RobMeades/DMUClass116/corridor_joiner.jpg

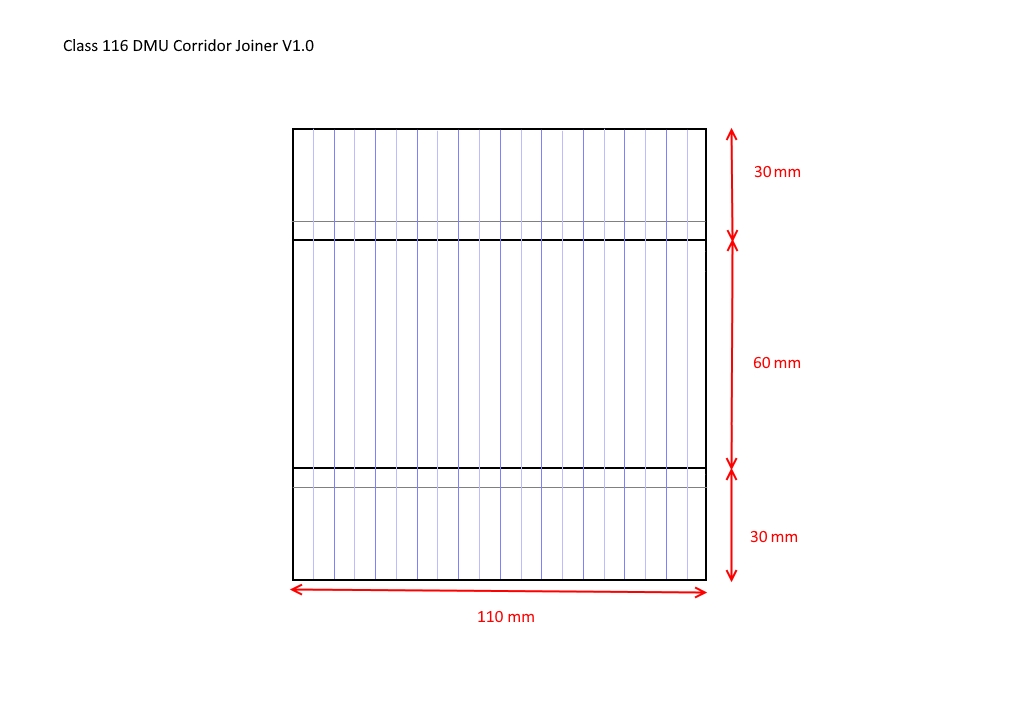
corridor_joiner.jpg
