RobMeades/DMUClass116/(list of files, cad)

Other CAD files:
body_internal_supports.blend
body_motor_open_second_and_brake_section_2.blend
body_motor_open_second_and_brake_section_3.blend
body_motor_open_second_brake_section_1.blend
body_motor_open_second_brake_section_4.blend
body_motor_open_second_brake_section_5.blend
body_motor_open_second_section_1.blend
body_motor_open_second_section_4.blend
body_motor_open_second_section_5.blend
body_roof_former.blend
buffer_bar.blend
cab_front_and_roof.blend
chassis.blend
corridor_joiner.blend
dmu_library.blend
drivers_steps.blend
partitions.blend
seats.blend
