RobMeades/DMUClass116/(commit log)

2019-01-08 Initial commit.
    [body.blend, cab_front_and_roof.blend, chassis.blend]
2019-01-09 Add note about resolution of chassis side printing.
2019-01-10 Add slots for battery holder.
2019-01-12 New version of cab front and roof with no requirements for added supports from a slicer and places for mounting LEDs in the head lamp holes.
    [cab_front_and_roof.blend]
2019-01-19 Correct 2.5 mm vertical offset in the VCarve files, minor mod to README.md.
2019-01-19 Move battery holder slots slightly.
2019-01-19 Re-correct the correction to the hole spacing (it's 1/32 scale, not 1/30.48 scale!).
2019-01-20 More advice on milling.
2019-01-22 Add driver's steps file.
    [drivers_steps.blend]
2019-01-27 Update chassis, add first proper body part and add library of components/tools.
    [body_motor_open_second_section_5.blend, chassis.blend, dmu_library.blend]
2019-01-27 Add lip to help with joining segments.
    [body_motor_open_second_section_5.blend]
2019-01-27 Add seats.
    [seat.blend]
2019-01-27 seat.blend -> seats.blend.
    [seat.blend]
2019-01-27 Really seat.blend -> seats.blend this time.
    [seats.blend]
2019-01-27 Add unpaired seats.
    [seats.blend]
2019-01-28 Add motor open second body section 4, update body section 5 and library, editorial changes to README.md.
    [body_motor_open_second_section_4.blend, body_motor_open_second_section_5.blend, dmu_library.blend]
2019-01-28 Updates mostly to the position of supports after test prints and also added a ridge, mid-body, for the separator in section 4. Editorial changes in README.md.
    [body_motor_open_second_section_4.blend, body_motor_open_second_section_5.blend]
2019-01-28 Move forward part of lower rim forward by 3 cm after test fitting.
    [body_motor_open_second_section_5.blend]
2019-01-28 Update seats after test print.
    [seats.blend]
2019-01-29 Update to seats after final test print.
    [seats.blend]
2019-01-29 Final length adjustments after test fitting.
    [body_motor_open_second_section_4.blend, body_motor_open_second_section_5.blend]
2019-01-30 Section 3 of the motor open second body added.
    [body_motor_open_second_section_3.blend]
2019-01-31 Minor edits after test print of motor body section 3.
    [body_motor_open_second_section_3.blend]
2019-02-01 Add section one of the motor open second body.
    [body_motor_open_second_section_1.blend]
2019-02-01 Add inner ridge to motor open body section 3 and removed drivers window punch from library (since, by inspection of the pictures, the driver's window is, in fact, the same height as the passenger win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
    [body_motor_open_second_section_3.blend, dmu_library.blend]
2019-02-02 Added final section (section 2) of motor open second body. Update section 1 of motor open second body after final test print. Modified seats to be narrower at the top. Minor updates to README.md.
    [body_motor_open_second_section_1.blend, body_motor_open_second_section_2.blend, seats.blend]
2019-02-02 Corrected height of windows in doors
    [body_motor_open_second_section_1.blend, body_motor_open_second_section_2.blend, body_motor_open_second_section_3.blend, body_motor_open_second_section_4.blend, body_motor_open_second_section_5.blend, dmu_library.blend]
2019-02-03 Add first revision of motor open second brake body section 5.
    [body_motor_open_second_brake_section_5.blend]
2019-02-03 Update to motor open body section 1 after final fitting of all the sections on the chassis. Add the gaps for the door steps to motor open second brake section 5.
    [body_motor_open_second_brake_section_5.blend, body_motor_open_second_section_1.blend]
2019-02-03 Minor fix in motor open second body section 1, general updates to README.md.
    [body_motor_open_second_section_1.blend]
2019-02-03 Add window supports to motor open brake section 5. Modify all window supports to print reliably in ASA.
    [body_motor_open_second_brake_section_5.blend, body_motor_open_second_section_1.blend, body_motor_open_second_section_2.blend, body_motor_open_second_section_3.blend, body_motor_open_second_section_4.blend, body_motor_open_second_section_5.blend, dmu_library.blend]
2019-02-04 Add a lip around the lower edge of all of the body sections to aid alignment and close up a potential gap. Add square nut holders to sections 1, 2 and 4. Minor updates to README.md.
    [body_motor_open_second_section_1.blend, body_motor_open_second_section_2.blend, body_motor_open_second_section_3.blend, body_motor_open_second_section_4.blend, body_motor_open_second_section_5.blend]
2019-02-05 Correct position of nut holder after test print.
    [body_motor_open_second_section_1.blend]
2019-02-05 Added holes to screw fixings and corrected support offset.
    [body_motor_open_second_section_4.blend]
2019-02-06 Reduce the window slot thickness to give the outer parts of the sides more strength. Finish motor open second brake section 5 and fix support positions in motor open second section 4.
    [body_motor_open_second_brake_section_5.blend, body_motor_open_second_section_1.blend, body_motor_open_second_section_2.blend, body_motor_open_second_section_3.blend, body_motor_open_second_section_4.blend, body_motor_open_second_section_5.blend]
2019-02-07 Add partitions.blend.
    [partitions.blend]
2019-02-07 Corrected slope of side on wide double seat.
    [seats.blend]
2019-02-07 Oops, restore accidentally deleted seats.blend.
    [seats.blend]
2019-02-07 Complete all of the partitions.
    [partitions.blend]
2019-02-08 Another minor seat slant adjustment and a final attempt to get the length of the motor open second body section 3 correct: 80 mm brute force this time to give me 2.5 mm in the print.
    [body_motor_open_second_section_3.blend, seats.blend]
2019-02-09 Put accidentally deleted seats.blend back again. Move 80 mm length extension on section 3 of the motor open second body into section 4 instead to avoid a slightly odd length door.
    [body_motor_open_second_section_3.blend, body_motor_open_second_section_4.blend, seats.blend]
2019-02-09 Add 2 mm margin to the rear of motor open second section 2 and add clarification concerning ASA printing in README.md.
    [body_motor_open_second_section_2.blend]
2019-02-10 Fix strange skew in motor open second section 2 (it was 3 cm shorter on the left than on the right). Remove lip from rear-most flange of motor open second section 1 as it was too difficult to put int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
    [body_motor_open_second_section_1.blend, body_motor_open_second_section_2.blend]
2019-02-10 Actually fix flange length of forward flange on motor open second section 1 this time; previous commit had fix for length of forward flange on motor open second section _2_.
    [body_motor_open_second_section_1.blend]
2019-02-10 Last commit was of an older file, make fix in the right file now and also shift the left-most nut trap to match its mate on section 2.
    [body_motor_open_second_section_1.blend]
2019-02-10 Removed spurious jigsaw object.
    [drivers_steps.blend]
2019-02-10 Hopefully really fix the darned wide seat pair slope this time.
    [seats.blend]
2019-02-11 Turn all the doors on the right hand sides of all motor open second body sections around so that they open the correct way; handles are always on the right as you face the door from the outside.
    [body_motor_open_second_section_1.blend, body_motor_open_second_section_2.blend, body_motor_open_second_section_3.blend, body_motor_open_second_section_4.blend, body_motor_open_second_section_5.blend]
2019-02-12 First draft of corridor_joiner.blend.
    [corridor_joiner.blend]
2019-02-12 Add final door stop on right hand driver's side door.
    [body_motor_open_second_section_1.blend, cab_front_and_roof.blend]
2019-02-12 Added lip on corridor joiner and made hole in end of motor open second body to take it.
    [body_motor_open_second_section_5.blend, corridor_joiner.blend]
2019-02-12 Corrected corridor joiner height.
    [body_motor_open_second_section_5.blend, corridor_joiner.blend, dmu_library.blend]
2019-02-13 Changed the form of the lip on the corridor joiner: it should now push inside the door-hole in motor open second body section 5.
    [corridor_joiner.blend]
2019-02-14 Adjust corridor joiner width/height once more, add some notes about printing flexible material to README.md.
    [corridor_joiner.blend]
2019-02-14 Remove the corridor joiner segment library part from dmu_library.blend as I've since modified the form quite a lot in corridor_joiner.blend.
    [dmu_library.blend]
2019-02-14 Switch the sub-surface modified back on on Motor Open Second Body section 2.
    [body_motor_open_second_section_2.blend]
2019-02-14 Triangulate one face I missed on Motor Open Second Body section 4.
    [body_motor_open_second_section_4.blend]
2019-02-15 Triangulate a few more faces on Motor Open Second Body section 1.
    [body_motor_open_second_section_1.blend]
2019-02-15 Fixed a few little funnies.
    [body_motor_open_second_section_4.blend]
2019-02-16 Reduce width of 2-seater seat slightly to accommodate the extra wall-thickness of the model.
    [seats.blend]
2019-02-16 Corrected driver's partition; moved the door to be central.
    [partitions.blend]
2019-02-16 Corrected corridor opening position in motor open second section 5, added same to motor open second brake section 5 and final update to drivers door partition.
    [body_motor_open_second_brake_section_5.blend, body_motor_open_second_section_5.blend, partitions.blend]
2019-02-17 First version of motor open second brake section 4, tidy up of motor open second brake section 5 and next version of corridor joiner plan.
    [body_motor_open_second_brake_section_4.blend, body_motor_open_second_brake_section_5.blend, corridor_joiner.blend]
2019-02-17 Add subsurface modifier and slightly increase size of rib after size test.
    [corridor_joiner.blend]
2019-02-17 Make the corridor joiner mould sacrificial.
    [corridor_joiner.blend]
2019-02-17 Position parts so that they are correct for printing without need for rotation in a slicer programme.
    [corridor_joiner.blend]
2019-02-17 Additional advice on how to print corrider_joiner.blend.
2019-02-17 Corridor joiner mould doesn't actually need to be sacrificed, it is flexible enough to be opened to remove the latex without breaking.
    [corridor_joiner.blend]
2019-02-21 Add blender_bar.blend and fix a name in dmu_library.blend.
    [buffer_bar.blend, dmu_library.blend]
2019-02-21 Update blender bar after test prints.
    [buffer_bar.blend]
2019-02-21 Corrected the height of the corridor joiner and increased the length of the corridor joiner mould in order to add more flexibility.
    [body_motor_open_second_brake_section_5.blend, body_motor_open_second_section_5.blend, corridor_joiner.blend]
2019-02-22 Finalised hole sizes for connectors.
    [buffer_bar.blend]
2019-02-27 Update corridor joiner and corridor joiner doorway dimensions.
    [body_motor_open_second_brake_section_5.blend, body_motor_open_second_section_5.blend, corridor_joiner.blend]
2019-02-28 Add VCarve files for motor open second brake base.
2019-03-03 Correct wording on seating count and update buffer bar to have fixing holes.
    [buffer_bar.blend]
2019-03-05 Emphasise importance of zero point when milling.
2019-03-05 Switch italics for bold.
2019-03-08 Added advice on heat bed temperature when printing the body sections.
2019-03-08 Open up the stops of the buffer bar once more since the buffer end is now round.
    [buffer_bar.blend]
2019-03-10 Add a gully for the hook spring.
    [buffer_bar.blend]
2019-03-24 Reduce depth of lower part of corridor joiner, editorial changes to README.md.
    [corridor_joiner.blend]
2019-03-28 Add body roof former.
    [body_roof_former.blend]
2019-03-31 Final versions of motor open second sections 4 and 5 as printed (with additional struts for the supports around the bottom edge). Rename sections 2 and 3 to be common to the motor open second and mot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
    [body_motor_open_second_and_brake_section_2.blend, body_motor_open_second_and_brake_section_3.blend, body_motor_open_second_section_5.blend]
2019-04-01 Former now takes a 108 mm styrene strip, which fits the roof better than a 104 mm strip.
    [body_roof_former.blend]
2019-04-06 Add destination plate to cab_front_and_roof.blend.
    [cab_front_and_roof.blend]
2019-04-07 Correct extent of lower edge.
    [body_motor_open_second_brake_section_4.blend]
2019-04-07 Correct roof flange.
    [body_motor_open_second_brake_section_5.blend]
2019-04-07 Remove writing on destination plate: it doesn't really print well enough, will use transfers instead.
    [cab_front_and_roof.blend]
2019-04-07 Version as finally printed.
    [body_motor_open_second_and_brake_section_3.blend]
2019-04-14 Correct manifoldness of the complex partition.
    [partitions.blend]
2019-04-14 Get length correct, finally.
    [body_motor_open_second_brake_section_5.blend]
2019-04-14 Remove mention of bowing base - it's not an issue if a brim is added and the temperatures are correct for ASA.
2019-04-16 Create an extra partition for the other side of the drivers' partition, final length corrections to body_motor_open_second_brake_section_4.blend, update README.md concerning partitions.blend.
    [body_motor_open_second_brake_section_4.blend, partitions.blend]
2019-04-16 And another adjustment of the clip-edge length.
    [body_motor_open_second_brake_section_4.blend]
2019-04-19 Minor adjustment to position of lower tab.
    [body_motor_open_second_brake_section_4.blend]
2019-04-19 Hinges at the extreme end moved to the correct side.
    [body_motor_open_second_and_brake_section_2.blend]
2019-04-23 Add windscreen wipers.
    [cab_front_and_roof.blend]
2019-04-25 Extend the cross-piece where the bolts go so that its inner edge aligns with the side of the nearby door: my printer tends to produce a distortion in the body side at this point and it is hidden if i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
    [body_motor_open_second_and_brake_section_2.blend]
2019-05-02 Align another edge of cross-piece to match the side of a door.
    [body_motor_open_second_brake_section_4.blend]
2019-05-08 Add motor open second brake version of body section 1.
    [body_motor_open_second_brake_section_1.blend]
2019-05-27 Add ventilation holes to the chassis box lid and editorial changes to README.md.
    [chassis.blend]
2019-06-02 Add body_internal_supports.blend and a README.md entry to match.
    [body_internal_supports.blend]
2019-06-05 Reduce the length of Motor Open Second Brake section 5 by 2 mm.
    [body_motor_open_second_brake_section_5.blend]
2019-06-07 Add LED support to body_internal_supports.blend.
    [body_internal_supports.blend]
2019-06-09 Update instructions for printing LED light fitting.
2019-06-15 Remove extraneous hinges on drivers' door.
    [body_motor_open_second_brake_section_1.blend, body_motor_open_second_section_1.blend]
2019-06-16 Correct position of hinges on left-hand side of rear-most door of motor open second brake section 4: they are on the opposite side to the rest since the door opens weirdly to accommodate the double-d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
    [body_motor_open_second_brake_section_4.blend]
2019-06-17 Remove extraneous door stop that used to go with the removed hinges.
    [body_motor_open_second_brake_section_4.blend]
2019-06-19 Corrected penultimate seats to the rear of motor open second: should be singles not doubles. Basically, each wide window has a double behind it and each narrow window has a single behind it.
2019-06-19 Corrected number of seats of each type to be printed.
2019-06-22 Revert previous change as it makes the cross-piece too long, making it get in the way of installing seating.
    [body_motor_open_second_and_brake_section_2.blend]
2019-06-22 Add seat variations to allow for installation around obstructions.
    [seats.blend]
2019-06-22 Reduced sub-division surface level on 3-seater single seat to 2 from 4 to match the rest.
    [seats.blend]
2019-06-22 Align naming of objects with web page text.
    [seats.blend]
2019-06-23 Increase the thickness of the seat on the double seats with cut-out as it was tending to come away from the supports during the 3D print.
    [seats.blend]
2019-06-25 Snip off the bottom of the cupboard behind the door of the guard's compartment as it fouls a cross-strut.
    [partitions.blend]
2019-06-28 Finally get the position of the hinges (and add door stops) correct after consultation with Alan Pitt of the Great Central Railway.
    [body_motor_open_second_brake_section_4.blend]
2019-07-12 Add note about step under door(s) of brake van.
2021-03-10 Remove the unnecessary and hidden parts from chassis.blend that will confuse people.
    [chassis.blend]
